westtrade/lesa-lsph-40/elem-peremychka.png

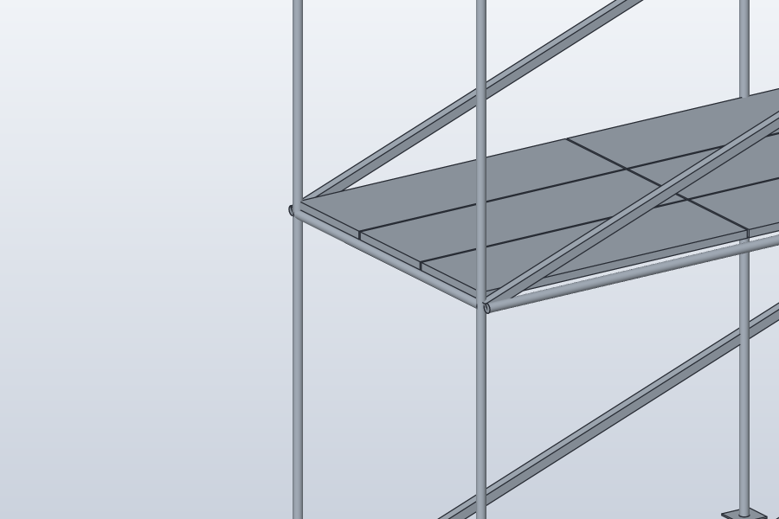
elem-peremychka.png
