westtrade/lesa-lsph-40/lesa-end.png

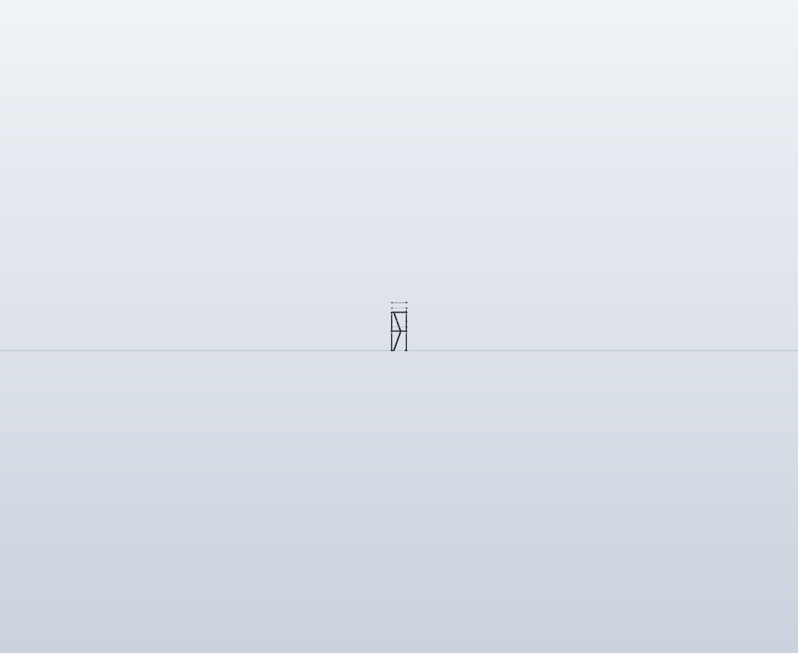
lesa-end.png
