westtrade/lesa-lsph-40/README.md

# Леса строительные ЛСПХ-40 — 60 м × 4 м

Проектный комплект: модель, виды, ведомость и расчёт.

**Дата расчёта:** 21.10.2026 · **источник номенклатуры и цен:** каталог ЛСПХ-40, <https://dzsl.ru/catalog/lspkh-40/>

Заказ: длина 60 м, высота 4 м, система ЛСПХ-40 (хомутовые).
**Условия:** работа в помещении (цех), монтаж крановых рельсов; пол — бетонная плита,
шаг колонн 6 м, рельсы длиной 21 м подаются краном; лестница одна (решение заказчика).

## Содержимое папки

| Файл | Что это |
|---|---|
| `index.html` | **Комплект одной страницей** (единственный HTML): схема, назначение элементов с фото, ведомость, подъём, раскосы, расчёт, виды, допущения. Tailwind вшит, автономный |
| `specifikaciya-LSPH-40.md` | Ведомость в Markdown: схема, спецификация, массы, стоимость, допущения |
| `raschet-LSPH-40.md` | Проверочный расчёт: нагрузки, стойка, перемычка, настил, раскос, анкеры, опрокидывание |
| `lesa-LSPH-40.solidcraft` | Параметрическая 3D-модель SolidCraft (456 тел, мм) |
| `lesa-LSPH-40.step` | Экспорт в STEP для сметчика / подрядчика (456 тел) |
| `lesa-iso.png` | Общий вид, изометрия (все 60 м) |
| `lesa-front.png` | Фасад 60 м, общий вид |
| `lesa-elev10m.png` | Фасад, приближённый вид (~14 м): ярусы, связи, перемычки |
| `lesa-end.png` | Торец (поперечная рама 1,5 × 4,0 м) |
| `lesa-plan.png` | План, приближённый вид (~13 м) |
| `lesa-top.png` | Вид сверху всей конструкции |
| `lesa-detail.png` | Изометрия, приближённый вид на начало лесов |
| `lesa-lestnica.png` | Узел подъёма: 2 марша лестницы и люк в настиле |
| `photo-lsph40.jpg`, `photo-lspkh60.jpg` | Фотографии лесов ЛСПХ с сайта производителя (dzsl.ru) |
| `elem-*.png` | Снимки отдельных элементов с модели: стойка, перемычка, связь 5,3, опора, настил, лестница |

`lesa-elev10m`, `lesa-plan`, `lesa-detail`, `lesa-lestnica` — это те же леса целиком,
только камера подведена (скрытых элементов нет): продольные связи и настил уходят за
правый край кадра и продолжаются, как в натуре. Общие виды — `lesa-iso`, `lesa-front`,
`lesa-top`. Все виды сняты с текущей модели (456 тел: настил на двух ярусах, люки, лестницы).

## Кратко

Схема: 60 м = 24 пролёта по 2,5 м; 25 осей × 2 ряда = 50 стоек; ширина яруса 1,5 м;
высота 4,0 м = 2 яруса по 2,0 м. Раскос — на два пролёта (5,0 м); диагональ панели
5,0 × 2,0 м равна 5,385 м, поэтому каталожная деталь 5,3 м ставится с креплением ниже
узла (подъём 1,758 м).

| Поз. | Наименование | Кол-во |
|---|---|---:|
| 1 | Стойка 4 м | 50 |
| 2 | Перемычка (1,452 м) | 50 |
| 3 | Связь 5,3 м (48 пояса + 20 раскосов) | 68 |
| 4 | Опора простая (башмак) | 50 |
| 5 | Кронштейн прямой (по колоннам через 6 м) | 8 |
| 6 | Кронштейн поворотный | 3 |
| 7 | Настил деревянный 0,5×1,5 | 240 |
| 8 | Лестница наклонная (одна, 2 марша) | 2 |
| 9 | Хомут поворотный / неповоротный | 304 (292 по расчёту + 4 %) |
| 10 | Анкер крепления к колонне M10 (2 на кронштейн) | 22 |

Итоги разделены: **позиции 1–8** — 468 шт., ≈ 6 144 кг, 317 124 ₽ (эта сумма и есть
оценённая стоимость); **весь комплект 1–10** — 797 шт., ≈ 6 256 кг; **с ограждениями (11–12)** — ≈ 7 462 кг, позиции 8–9 — по запросу.

**Как забираться**: настил на обоих ярусах + 3 наклонные лестницы по 2 марша
(земля → +2,0 м → +4,0 м), выход через люк 0,6 × 0,7 м в настиле. Марш: подъём 2 024 мм,
тетива 2 154 мм, уклон 70°, проекция 737 мм, 6 ступеней с шагом 289 мм (≤ 300 мм).
Узел подъёма — `lesa-lestnica.png`.

**Почему раскосы так**: узел на хомутах шарнирный, неизменяемость даёт треугольник.
Раскос идёт на два пролёта (5,0 м). Диагональ панели 5,0 × 2,0 м равна 5,385 м, то есть
каталожная деталь 5,3 м на 85 мм короче и «узел-в-узел» не встаёт — конец крепится
хомутом к стойке ниже узла (подъём 1,758 м, 19,4°); в модели раскос ровно 5 300 мм.
Блоки — 5 шт. (пролёты 1–2, 6–7, 12–13, 18–19, 22–23), наибольший участок без раскоса
10 м. Достаточность шага связей проверяется расчётом/ППР; консервативный вариант —
12 блоков: 96 связей, 362 хомута, 22 анкера, ≈ 6 847 кг (≈ 6,8 т округлённо), 364 276 ₽ — оценка позиций 1–8.

Подробности и допущения — в `specifikaciya-LSPH-40.md`.
