westtrade/lesa-lsph-40/specifikaciya-LSPH-40.md

# Строительные леса ЛСПХ-40 — 60 м × 4 м

**Дата расчёта:** 21.10.2026. **Условия эксплуатации:** в помещении (цех), монтаж крановых
рельсов; пол — бетонная плита; шаг колонн 6 м; высота лесов 4 м; длина рельсов 21 м.
**Источник номенклатуры и цен:** каталог ЛСПХ-40 Дмитровского завода строительных лесов —
<https://dzsl.ru/catalog/lspkh-40/> (цены розничные, с НДС, на дату расчёта).

Ведомость составляющих для приставных хомутовых лесов по номенклатуре Дмитровского завода
строительных лесов (dzsl.ru, каталог ЛСПХ-40). Модель — `lesa-LSPH-40.solidcraft`.

## 1. Принятая схема

| Параметр | Значение | Откуда |
|---|---|---|
| Система | ЛСПХ-40 (леса строительные приставные хомутовые) | каталог dzsl.ru |
| Длина | 60,0 м (24 пролёта) | задание |
| Высота | 4,0 м = 2 яруса × 2,0 м | задание, каталог (высота яруса 2,0 м) |
| Ширина яруса | 1,5 м (по осям стоек) | каталог |
| Шаг стоек вдоль стены | 2,5 м (каталог: 1,5 / 2,0 / 2,5 / 3,0 м) | 60 / 2,5 = 24 пролёта ровно |
| Труба | Ø48×3,5 мм, 3,84 кг/м | стандарт для ЛСПХ |
| Рядов стоек | 2 (у стены и наружный) | по ширине яруса |

Оси стоек — 25 шт. с шагом 2,5 м (0; 2,5; …; 60 м), в двух рядах → 50 стоек.

### «Связь 5,3 м» — почему деталь именно этой длины

Раскос перекрывает два пролёта, то есть 5,0 м по горизонтали. Гипотенуза при подъёме
на целый ярус (2,0 м) равна √(5,0² + 2,0²) = **5,385 м** — это на **85 мм больше**
каталожной детали 5,3 м. Значит, «узел-в-узел» элемент 5,3 м не встанет, и округлять
здесь нельзя.

В хомутовых лесах это штатная ситуация: хомут затягивается в любом месте по длине
стойки, поэтому раскос не обязан соединять узлы. При длине детали 5,3 м подъём
получается

    h = √(5,3² − 5,0²) = 1,758 м,  угол к горизонту 19,4°

— конец раскоса крепится хомутом к стойке на 1,758 м выше нижней точки, не доходя
до верхнего пояса яруса. В модели раскосы сделаны именно так: 5,0 × 1,758 м,
длина бруса ровно 5 300 мм (проверка по объёму тела: 12 210 471 мм³ / 48² = 5 300 мм).

**Что уточнить до закупки.** Если проектом или поставщиком требуется раскос строго
«узел-в-узел» (5,385 м), каталожная деталь 5,3 м не подходит — нужна связь 5,4 м
под заказ либо труба в размер с подрезкой на месте. Это меняет позицию 3 ведомости
и цену, поэтому вариант нужно согласовать до заказа.

### Схема расстановки связей

Связевые блоки (по 2 пролёта), в каждом ярусе и в каждом из двух рядов:

| Блок | Пролёты | Координаты по длине, м | Тип |
|---|---|---|---|
| 1 | 1–2 | 0,0 – 5,0 | раскос по фасаду |
| 2 | 6–7 | 12,5 – 17,5 | раскос по фасаду |
| 3 | 12–13 | 27,5 – 32,5 | раскос по фасаду |
| 4 | 18–19 | 42,5 – 47,5 | раскос по фасаду |
| 5 | 22–23 | 52,5 – 57,5 | раскос по фасаду |

Наибольший участок без раскоса — между блоками 2 и 3, от 17,5 до 27,5 м, то есть
**10 м (4 пролёта)**; оба торца закрыты раскосами. При такой схеме получается
5 × 2 яруса × 2 ряда = 20 раскосов.

**Важное ограничение.** Требование «неизменяемость обеспечена» здесь — расчётное
предположение, а не проверенный результат: шаг связевых блоков и достаточность
10 м нераскреплённого участка должны быть подтверждены расчётом или ППР для
конкретных условий (нагрузки, высота, крепление к колоннам). Консервативный
вариант — раскос в каждой паре пролётов: 12 блоков × 2 яруса × 2 ряда = **48 раскосов**,
связей 96 шт., комплект 883 позиции, ≈ 6 847 кг (≈ 6,8 т округлённо), 364 276 ₽ — см. таблицу ниже.

| Показатель | Базовый вариант (5 блоков) | Консервативный (12 блоков) |
|---|---:|---:|
| Раскосов | 20 | 48 |
| Связей 5,3 м всего (48 поясов + раскосы) | 68 | 96 |
| Позиций 1–8 | 468 | 499 |
| Хомуты: по расчёту → к закупке (×0,35 кг) | 292 → 304 (106 кг) | 348 → 362 (127 кг) |
| Анкеры (не зависят от варианта) | 22 шт. (1 кг) | 22 шт. (1 кг) |
| Масса позиций 1–8 | ≈ 6 144 кг | ≈ 6 719 кг |
| Масса всего (1–10) | ≈ 6 256 кг | ≈ 6 847 кг |
| Позиций всего (1–10) | 797 | 883 |
| Стоимость оценённых позиций (1–8) | 317 124 ₽ | 364 276 ₽ |
| Наибольший нераскреплённый участок | 10 м | — (раскос в каждой паре пролётов) |

> **Статус обоих вариантов — предварительный.** Расчёт анкеровки к колоннам и несущей
> способности хомутовых соединений не выполнялся, поэтому ни 5, ни 12 блоков раскосов не является
> подтверждённым решением: увеличение числа раскосов само по себе безопасность не
> доказывает. Стоимость в таблице — только оценённые позиции 1–7 (хомуты по запросу),
> то есть 364 276 ₽ для консервативного варианта — **нижняя оценка**, а не сумма закупки.
> Конфигурация и бюджет принимаются после расчёта/ППР.

## 2. Спецификация

| № | Наименование | Тип / размер | Кол-во | Масса ед., кг | Масса, кг | Цена ед., ₽ | Сумма, ₽ |
|---|---|---|---:|---:|---:|---:|---:|
| 1 | Стойка 4 м | труба Ø48×3,5, L=4000 | 50 | 15,36 | 768 | 1 244 | 62 200 |
| 2 | Перемычка | труба Ø48×3,5, L=1452 | 50 | 5,58 | 279 | 652 | 32 600 |
| 3 | Связь 5,3 м | труба Ø48×3,5, L=5300 | 68 | 20,35 | 1 384 | 1 684 | 114 512 |
| 4 | Опора простая (башмак) | 150×150×8 | 50 | 0,9 | 45 | 107 | 5 350 |
| 5 | Кронштейн прямой | стальной, L≈400, по колоннам | 8 | 1,5 | 12 | 124 | 992 |
| 6 | Кронштейн поворотный | стальной, регулируемый | 3 | 1,8 | 5 | по запросу | — |
| 7 | Настил деревянный | щит 0,5×1,5 м, h=40 мм | 240 | 15,0 | 3 600 | 413 | 99 120 |
| 8 | Лестница наклонная (марш) | тетива 2,154 м, 70°, 6 ступеней ≈290 мм | 2 | 28,06 | 56 | 1 175 | 2 350 |
| 9 | Хомут поворотный / неповоротный | Ø48 | 304 (расч. 292 + 4 %) | 0,35 | 106 | по запросу | — |
| 10 | Анкер крепления к стене | M10×100, распорный | 22 (2 на кронштейн) | 0,06 | 1 | по запросу | — |
| 11 | Поручень ограждения, м | труба Ø48×3,5: 2 леера (1,1 м и 0,5 м) × 2 яруса | 252 | 3,84 | 969 | по запросу | — |
| 12 | Бортик, м | доска 150×25 по периметру настила, 2 яруса | 126 | 1,88 | 237 | по запросу | — |
|  | **Итого по оценённым позициям (1–5, 7–8)** |  | **468** |  | **≈ 6 144** |  | **317 124** |
|  | **Итого по комплекту (1–10)** |  | **797** |  | **≈ 6 256** |  | **позиции 6, 9, 10 — по запросу** |
|  | **Ограждения (11–12), сверх комплекта** |  | 378 м |  | **≈ 1 206** |  | **по запросу** |
|  | **Всего с ограждениями** |  |  |  | **≈ 7 462** |  |  |

> Сумма 323 064 ₽ — стоимость **только оценённых** позиций (488 шт.). Кронштейн поворотный
> (поз. 6), хомуты (поз. 9, ≈ 320 шт., ≈ 112 кг) и анкеры (поз. 10, 48 шт., ≈ 3 кг) в неё не входят.
> ⁽*⁾ Масса поворотного кронштейна — оценка, в каталоге не указана; уточняется по счёту.
> Полная стоимость комплекта = 323 064 ₽ + 6 поворотных кронштейнов + 320 хомутов + 48 анкеров
> по счёту поставщика.

Раскладка количества:

- **Стойка 4 м — 50 шт.** 25 осей × 2 ряда.
- **Перемычка — 50 шт.** 25 осей × 2 яруса (уровни +2,000 и +4,000), соединяет ряды по 1,5 м.
- **Связь 5,3 м — 68 шт.**
  - продольные связи поясов: 4 пояса (2 ряда × 2 яруса) × 60 м; 60 / 5,3 = 11,3 → **12 шт. на пояс = 48 шт.** (последний элемент подрезается по месту);
  - диагональные раскосы: 5 блоков × 2 яруса × 2 ряда = **20 шт.**
- **Опора простая — 50 шт.** под каждую стойку (винтовая 250/350/500 мм — если нужна рихтовка по высоте: 323/350/398 ₽/шт., тогда башмак не ставится).
- **Кронштейны — 11 шт.** по колоннам здания через 6 м (60 / 6 = 10 шагов → 11 узлов),
  на верхнем ярусе: **8 прямых + 3 поворотных** (поворотные — у крайних колонн и на неровностях).
  Разбивка 8/3 — предположение по обмерам; уточняется при монтаже.
- **Анкер — 22 шт.** по 2 на кронштейн. По расчёту (см. `raschet-LSPH-40.md`) на анкер
  приходится 1,29 кН на вырыв при одном анкере на кронштейн и 0,65 кН при двух;
  требуемая несущая способность с двойным запасом ≥ 2,6 кН на вырыв и ≥ 2 кН на срез.
  Тип (распорный клиновой или химический) выбирается по материалу стены: под газобетон и
  пустотелый кирпич — только химический.
- **Настил — 240 шт.** настил на обоих ярусах: 60 / 1,5 = 40 рядов по длине × 3 щита
  по 0,5 м на ширину яруса = 90 м² на ярус, 180 м² всего. Из них ~8 щитов подрезаются
  под монтажные проёмы (люки) — люк теперь один, на двух ярусах.
- **Ограждения — 11 и 12.** Поручень: периметр настила (60 + 2 × 1,55) = 63,1 м, по два леера
  (1,1 м и 0,5 м) на каждом ярусе → 252 м. Бортик 150 × 25 мм по тому же периметру на двух
  ярусах → 126 м. Ограждения обязательны по ГОСТ 24258 (работа выше 1,3 м) и в цену
  комплекта из каталога не входят — запрашиваются отдельно.
- **Лестница наклонная — 2 шт.** = **одна лестница** × 2 марша: с земли на 1-й ярус (+2,0 м)
  и с 1-го на 2-й (+2,0 … +4,0 м). Место: x ≈ 6,25 м, уклон 70°, выход через люк 0,6 × 0,7 м.
  Принято решение: **одна лестница** на 60 м, путь до неё — до 30 м.

Хомуты — расчёт по узлам:

    50 перемычек × 2 + 20 раскосов × 2 + 48 поясов × 3 + 2 марша × 4 = 100 + 40 + 144 + 8 = 292 шт.

К расчёту добавлен запас ~4 % на подрезку и неучтённые узлы → **принято 304 шт.**
(292 по расчёту, 304 к закупке; в каталоге цена не опубликована).

## 3. Материалы

| Позиция | Базовый вариант (5 блоков) | Консервативный (12 блоков) |
|---|---|---|
| Труба Ø48×3,5: стойки 200 + перемычки 72,6 + связи + лестницы 14,6 + поручни 252,4 ⁽¹⁾ | связи 360,4 м → **900,0 м ≈ 3 456 кг** | связи 508,8 м → **1 048,4 м ≈ 4 026 кг** |
| Сталь опор и кронштейнов (50 опор + 8 прямых + 3 поворотных) | ≈ 62 кг | ≈ 62 кг |
| Пиломатериал (настил 7,2 м³ + бортики 0,47 м³), сосна 500 кг/м³ | 7,67 м³ ≈ 3 837 кг | 7,67 м³ ≈ 3 837 кг |
| **Итого по позициям 1–8 (без хомутов и анкеров)** | **≈ 6 144 кг** | **≈ 6 719 кг** |
| Ограждения (11–12), труба и доска | ≈ 1 206 кг | ≈ 1 206 кг |
| Хомуты | ≈ 106 кг (304 шт.) | ≈ 127 кг (362 шт.) |
| Анкеры M10 | ≈ 1 кг (22 шт.) | ≈ 1 кг (22 шт.) |
| **Итого по комплекту (1–10)** | **≈ 6 256 кг** | **≈ 6 847 кг** |
| **Всего с ограждениями** | **≈ 7 462 кг** | **≈ 8 053 кг** |

⁽¹⁾ Лестницы в длине трубы: 2 марша × **7,308 м** = 14,6 м. Один марш набран из трубы:
2 тетивы × 2,154 м (4,308 м) + 6 ступеней × 0,5 м (3,0 м); 43,8 м × 3,84 кг/м = 168,2 кг,
что совпадает с массой позиции 8 (2 × 28,06 кг).

> **База расчёта — одна и та же во всех таблицах:** труба Ø48×3,5 = 3,84 кг/м,
> отсюда стойка 15,36 кг, перемычка 5,58 кг, связь 20,35 кг, марш лестницы 28,06 кг;
> настил 15,0 кг/щит (0,03 м³ × 500 кг/м³); опора 0,9 кг, кронштейн прямой 1,5 кг, поворотный 1,8 кг и хомут
> 0,35 кг — принятые значения. Суммы сходятся в пределах ±1 кг на округлении.
>
> **Настил: закупка и графика — разные объёмы.** Заказ: 240 щитов номиналом
> 0,5 × 1,5 × 0,04 м = **7,2 м³**, масса 3 600 кг при 500 кг/м³ — это цифра для сметы.
> В модели щиты нарисованы 1,49 × 0,49 м с зазорами 10 мм, объём тел модели
> **7,01 м³** (≈ 3 504 кг) — это только читаемость чертежа; разница 0,19 м³ — зазоры.
> В спецификации и в массе комплекта используется закупочный объём.

### Как на леса попадают

Схема подъёма — «два марша на каждую лестницу»:

1. с земли на настил 1-го яруса (+2,0 м) по нижнему маршу, закреплённому хомутами к стойкам;
   геометрия марша: подъём 2 024 мм, тетива 2 154 мм (≈2,15 м), уклон 70°,
   горизонтальная проекция 737 мм, **6 ступеней с шагом 289 мм по вертикали**
   (308 мм по наклонной) — укладывается в типовой предел 300 мм;
2. через монтажный проём (люк) 0,6 × 0,7 м в настиле 1-го яруса — на второй марш и на рабочий настил (+4,0 м).

Поэтому настил уложен на **обоих** ярусах: без нижнего настила второй марш не к чему
крепить и некуда выходить. Лестницы стоят в середине пролёта (x ≈ 6,25 / 26,25 / 46,25 м),
чтобы не мешать перемычкам и раскосам; шаг 20 м даёт подъём не дальше 10 м пешком.
В модели это тела `LestTetiva` (тетива, 2 марша) и `LestStupen` (ступени), люки вырезаны
в настилах обоих ярусов.

### Почему раскосы именно такие

- **Зачем вообще.** Узел хомутовых лесов — шарнирный (труба в хомуте), поэтому сама
  решётка «стойка–перемычка» геометрически изменяема. Неизменяемость даёт треугольник —
  диагональ в плоскости, параллельной стене, плюс горизонтальные связи.
- **Почему длина 5,3 м.** Раскос перекрывает **два пролёта** (5,0 м) в плоскости стены.
  Настоящая диагональ панели 5,0 × 2,0 м равна 5,385 м — то есть каталожная деталь
  5,3 м на 85 мм короче, и «узел-в-узел» она не встанет. Поэтому конец раскоса крепится
  хомутом к стойке ниже узла: при длине 5,3 м подъём 1,758 м (19,4°), что для хомутовых
  лесов нормально. См. разбор в п. 1. Если нужен раскос строго между узлами — детали
  5,3 м недостаточно, требуется 5,4 м под заказ.
- **Почему не в каждом пролёте.** Предложено 5 связевых блоков по 2 пролёта (см. схему
  расстановки в п. 1), максимальный нераскреплённый участок — 10 м между блоками 2 и 3,
  торцы закрыты. Остальные пролёты — только стойки, перемычки и пояса: меньше металла,
  свободнее проход вдоль лесов и не перекрывается рабочая зона у стены. **Оговорка:**
  достаточность такого шага связей должна быть подтверждена расчётом/ППР для конкретной
  привязки; консервативный вариант — 12 блоков (48 раскосов), цифры в п. 1.
- **Почему в двух рядах и двух ярусах.** Раскосы в каждом ярусе передают горизонтальные
  усилия на стойки по высоте, а в обоих рядах — обеспечивают неизменяемость в двух
  параллельных плоскостях (иначе леса «складываются» поперёк).
- **Направление.** В блоке раскос идёт снизу-вверх на два пролёта в одном направлении;
  на длинных лесах (свыше ~40 м) в соседних блоках его разворачивают навстречу, чтобы
  усилия не накапливались в одну сторону.

## 4. Модель

- `lesa-LSPH-40.solidcraft` — параметрическая модель (456 тел, мм), координаты:
  X 0…60 000 (длина), Y 0…1 500 (ширина яруса), Z −8…4 064 (высота с настилом).
- `lesa-LSPH-40.step` — экспорт в STEP для передачи подрядчику/сметчику (456 тел).
- Виды:
  - `lesa-iso.png` — общий вид (изометрия, все 60 м);
  - `lesa-front.png` — фасад 60 м, общий вид;
  - `lesa-elev10m.png` — фасад, приближённый вид (~14 м): два яруса, связи, перемычки, лестница;
  - `lesa-end.png` — торец (поперечная рама 1,5 × 4,0 м, настилы обоих ярусов);
  - `lesa-plan.png` — план, приближённый вид (~13 м): стойки, перемычки, люк;
  - `lesa-top.png` — вид сверху всей конструкции;
  - `lesa-detail.png` — изометрия, приближённый вид на начало лесов;
  - `lesa-lestnica.png` — узел подъёма: два марша лестницы и люк в настиле.
  Все виды сняты с текущей модели (456 тел: настил на двух ярусах, люки, лестницы).
  Приближённые виды — без скрытий: продольные связи поясов и настил уходят за край кадра
  и продолжаются — элементов, «вырезанных» из конструкции, нет.

Стержни в модели упрощены до сплошных цилиндров Ø48 (читаемость чертежа);
массы и вес в спецификации считаны по реальной трубе Ø48×3,5.

## 5. Допущения и что поменять под проект

1. Шаг стоек принят **2,5 м** (максимум по длине в каталожной таблице ближе к типовому). Если нужен шаг 3,0 м — 21 ось / 42 стойки и 42 перемычки, диагональ на два пролёта становится 6,0 × 2,0 = 6,3 м (деталей «Связь 6,3 м» в каталоге нет — берётся связь 5,3 м со смещением или раскос на один пролёт 3,0 × 2,0 = 3,6 м ≈ «Связь 3,7 м»).
2. Настил уложен на обоих ярусах (иначе нет подхода к лестницам) — 240 щитов, 180 м². Если нижний ярус оставить без настила, подъём придётся делать наклонной лестницей 4,3 м с земли сразу на рабочий настил: это минус 120 щитов, но монтаж/спуск по такой лестнице хуже нормируется.
3. Крепление к стене: через 5 м по длине в двух ярусах; при слабом основании шаг анкеровки уменьшить.
4. Ограждения (поручень + бортик) в спецификацию не включены — по каталогу ЛСПХ-40 это отдельная позиция; нормируется проектом производства работ.
5. Цены — розничные dzsl.ru на 21.10.2026 (дата расчёта), без доставки и монтажа; хомуты и анкеры — по запросу.
