westtrade/lesa-lsph-40/raschet-LSPH-40.md

# Проверочный расчёт лесов ЛСПХ-40 (60 × 4 м)

**Дата расчёта:** 21.10.2026. **Исходные данные по номенклатуре и ценам:** <https://dzsl.ru/catalog/lspkh-40/>.
**Условия:** работа в помещении (монтаж крановых рельсов); пол — бетонная плита;
шаг колонн 6 м; высота лесов 4 м; рельсы длиной 21 м подаются краном.

**Статус документа.** Это проверочный (оценочный) расчёт по нормативным формулам, выполненный
по модели и ведомости комплекта. Он показывает, какие проверки проходят и с каким запасом, и
какие условия обязательны для эксплуатации. Он **не заменяет** проект производства работ
(ППР), не является заключением эксперта и не подписан аттестованным специалистом: перед
монтажом расчёт привязывается к объекту (грунт основания, тип и состояние стены, тип анкера,
район строительства) и утверждается в ППР.

## 1. Исходные данные

| Параметр | Значение |
|---|---|
| Схема | 60 м = 24 пролёта × 2,5 м; ширина яруса 1,5 м; 2 яруса × 2,0 м |
| Стойки | 25 осей × 2 ряда = 50; труба Ø48×3,5 |
| Материал | сталь С245: R<sub>y</sub> = 245 МПа, E = 2,06·10⁵ МПа; настил — сосна: R<sub>и</sub> = 13 МПа, E = 1·10⁴ МПа |
| Сечение трубы | A = 489,3 мм², I = 121 867 мм⁴, i = 15,78 мм, W = 5 078 мм³ |
| Ветровая нагрузка | **отсутствует** — закрытое помещение (п. 1.4: ветер внутри не учитывается) |
| Нормы | СП 20.13330.2016 (нагрузки), СП 16.13330.2017 (сталь), СП 64.13330.2017 (дерево), ГОСТ 24258 (средства подмащивания) |

Допущение по аэродинамике: c = 1,2; коэффициент заполнения несущего контура φ = 0,05 (каркас
без полотна) и φ = 0,70 (смонтирована фасадная сетка). Расчёт ведётся по худшему случаю — с сеткой.

## 2. Нагрузки

- **Постоянная** (настил): щит 15 кг на 0,75 м² → 0,20 кПа. Собственный вес каркаса 2,6 т
  на 240 м² фасада → 0,11 кПа (в расчёте стоек учтён через весовую нагрузку настила и запас).
- **Полезная** на рабочем настиле: **2,0 кПа (200 кг/м²)** — принято по эксплуатационной
  нагрузке лесов; эта же величина покрывает снеговую нагрузку III района (1,5 кПа).
- **Ветровая**: внутри помещения **не учитывается** (F = 0). Это снимает проверку на
  опрокидывание, которая на улице была определяющей.
- **Особый случай — рельс**: рельс длиной 21 м (КР‑70 ≈ 1,1 т, КР‑80 ≈ 1,3 т) подаётся краном
  и укладывается сразу на подкрановые балки. **На настил лесов он не складируется**: сосредоточенная
  нагрузка от куска 12 м (6,2 кН на щит) даёт σ = 17,2 МПа при допустимых 13 МПа — превышение;
  кусок до 6–8 м (3,1 кН) проходит с σ = 8,6 МПа.

## 3. Проверки

| № | Проверка | Усилие | Несущая способность | Использование | Вывод |
|---|---|---|---:|---:|---|
| 1 | Стойка, сжатие с учётом устойчивости | N = 16,5 кН | 36,0 кН (φ·A·R<sub>y</sub>, φ = 0,30) | **46 %** | проходит |
| 2 | Перемычка, изгиб | M = 725 Н·м | σ = 143 МПа при R<sub>y</sub> = 245 МПа | **58 %** | проходит |
| 3 | Настил, изгиб | M = 284 Н·м | σ = 2,17 МПа при 13 МПа | **17 %** | проходит |
| 4 | Раскос, сжатие | N = 0,51 кН | 8,8 кН (эйлерово) | **6 %** | проходит |
| 5 | Анкер к колонне, вырыв | 0,3 кН (случайная нагрузка, принято) | анкер M10 распорный: ≥ 2 кН | **15 %** | проходит |
| 6 | Давление на пол под башмаком | p = 0,73 МПа | R<sub>b</sub> бетона B20 = 11,5 МПа | **6 %** | проходит |
| 7 | Устойчивость | ветра нет; фиксация — 11 кронштейнов к колоннам | конструктивно | — | обеспечено |
| 8 | Ограждения (ГОСТ 24258) | поручень 1,1 м + промежуточный 0,5 м + бортик 150 мм | нормируется, не расчётом | — | выполняется конструкцией |

Пояснения к числам:

1. **Стойка.** Грузовая площадь 2,5 × 1,5 = 3,75 м²; N = (2,0 + 0,2) · 3,75 = 8,25 кН на ярус,
   при загружении двух ярусов — 16,5 кН. Расчётная длина l<sub>ef</sub> = 2,0 м (ярус раскреплён
   перемычками): λ = 127, λ̄ = 4,37; критическая сила по Эйлеру 61,9 кН. Коэффициент
   продольного изгиба φ = 0,30 (кривая b); при φ = 0,25 использование 55 %, при 0,35 — 39 %,
   то есть даже при разбросе табличного φ запас остаётся.
2. **Перемычка.** Пролёт 1,452 м, грузовая полоса 1,25 м: q = 2,75 Н/мм; прогиб 6,34 мм =
   L/229 (для лесов допускается L/150).
3. **Настил.** Щит 490 × 40 мм, пролёт 1,452 м: прогиб 2,39 мм = L/608.
4. **Раскос.** Сдвиг на панель 2,5 × 2,0 м — 0,48 кН; усилие в раскосе 0,51 кН при
   критической силе 8,8 кН (сжатие раскоса не является определяющим).
5. **Анкеры.** Внутри помещения отрывающих усилий от ветра нет, поэтому анкеры работают как
   фиксаторы: расчётное усилие принято 0,3 кН на анкер (случайные толчки, работа с рельсом,
   наезд инструмента). Принято **2 анкера на кронштейн, 22 шт.** (позиция 10 ведомости) —
   с запасом к любому распорному M10, у которого допустимая нагрузка ≥ 2 кН. Под газобетон
   и пустотелый кирпич — химический анкер; здесь основание — бетонная плита.
6. **Пол.** Нагрузка от стойки 16,5 кН распределяется башмаком 150 × 150 мм: p = 0,73 МПа,
   что в 15 раз ниже прочности бетона B20 на сжатие. Для пола по грунту или старого
   асфальта нужны распределительные подкладки 300 × 300 мм.
7. **Устойчивость.** Ветер отсутствует, опрокидывающий момент не возникает. Леса фиксируются
   11 кронштейнами по колоннам через 6 м; при случайном боковом воздействии усилие на
   кронштейн не превышает 0,5 кН — запас по анкеру более чем четырёхкратный.

## 4. Выводы

1. Несущая способность каркаса обеспечена с запасом: наибольшее использование — 58 %
   (перемычка на изгиб), стойка — 46 %, настил — 17 %.
2. **Анкеровка — конструктивная, а не несущая**: ветра в помещении нет, опрокидывание
   невозможно. Достаточно 11 кронштейнов по колоннам через 6 м и 22 анкера (по 2 на кронштейн).
   Это упрощает и удешевляет крепление по сравнению с уличным вариантом.
3. **Определяющими для цеха становятся не ветер, а пол и рельс.** Пол — бетонная плита,
   запас 15-кратный. Рельс 21 м (1,1–1,3 т) на настил не складируется: подаётся краном и
   сразу укладывается на подкрановые балки; на лесах только люди и инструмент (≤ 200 кг/м²).
4. **Ограждения обязательны**: работа на высоте выше 1,3 м — поручень на 1,1 м, промежуточный
   леер на 0,5 м и бортик 150 мм по периметру настила на обоих ярусах (позиции 11–12 ведомости,
   252 м поручня и 126 м бортика, ≈ 1 206 кг). По ГОСТ 24258 они нормируются, а не рассчитываются.
5. Работа идёт в зоне действия крана: нужно согласование с лицом, ответственным за
   безопасную эксплуатацию ГПМ, отключение и блокировка крана на время работ, запрет
   складирования на путях крана.

## 5. Что этим расчётом не проверено

- местная устойчивость стенки трубы (D/t = 13,7 — в пределах нормы, но с учётом коррозии
  толщину надо подтверждать толщиномером);
- несущая способность **хомутовых соединений** — она принимается по паспорту лесов, а не
  расчётом; это отдельное слабое место системы;
- основание под опорами (просадка, уклон площадки), тип и качество анкера, прочность
  материала стены (кирпич/газобетон/монолит) — определяется на объекте;
- динамика от людей, температурные воздействия, сейсмика, усталость, длительная ползучесть
  деревянного настила, работа при обледенении;
- ограждения (поручень, бортик) в комплект не входят и в расчёте не участвуют.

**Для легитимности документа нужны:** привязка к объекту, подпись аттестованного
инженера-конструктора и включение расчёта в ППР.
