westtrade/lesa-lsph-40/elem-lestnica.png

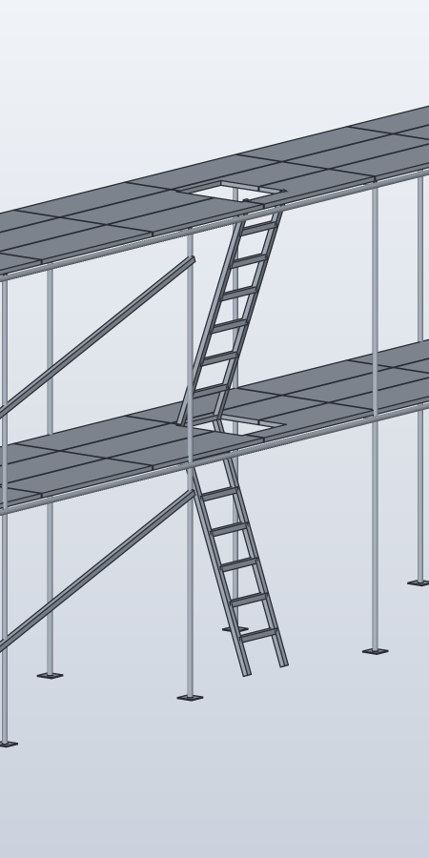
elem-lestnica.png
