westtrade/lesa-lsph-40/elem-nastil.png

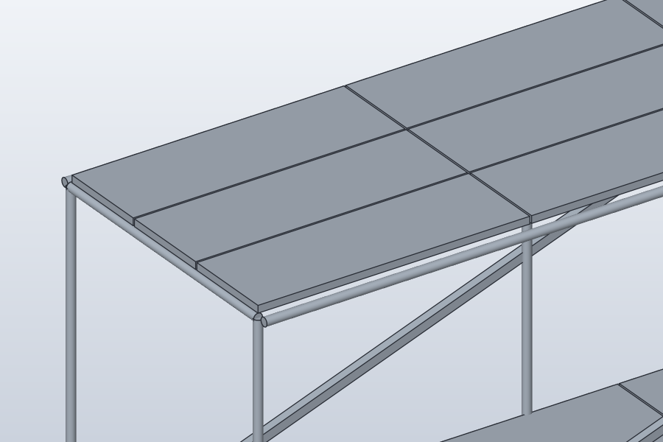
elem-nastil.png
