westtrade/lesa-lsph-40/elem-opora.png

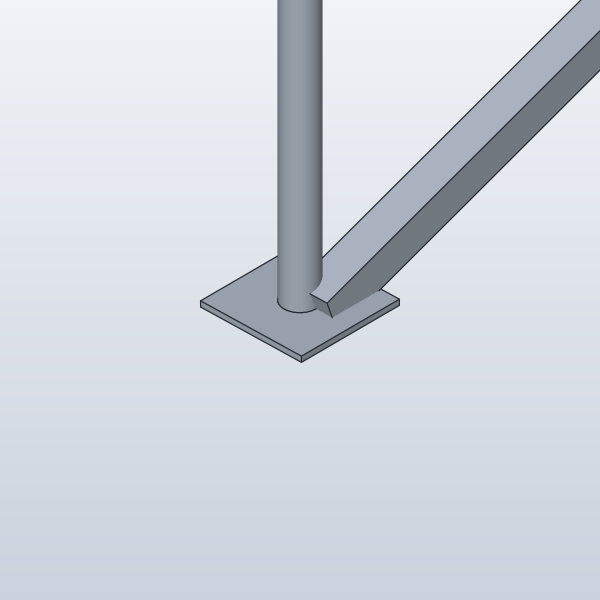
elem-opora.png
