westtrade/lesa-lsph-40/elem-stoyka.png

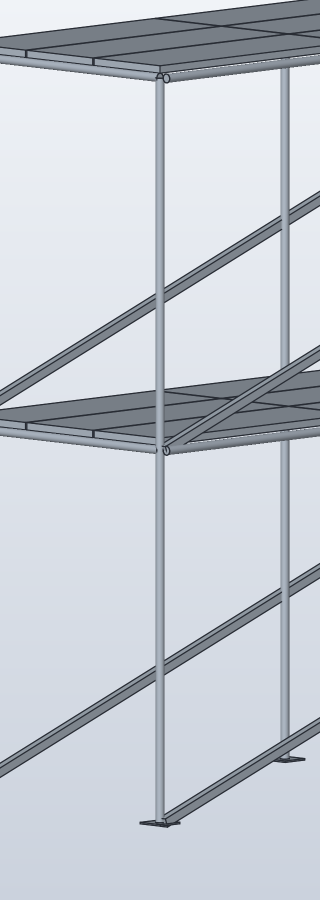
elem-stoyka.png
