westtrade/lesa-lsph-40/elem-svyaz.png

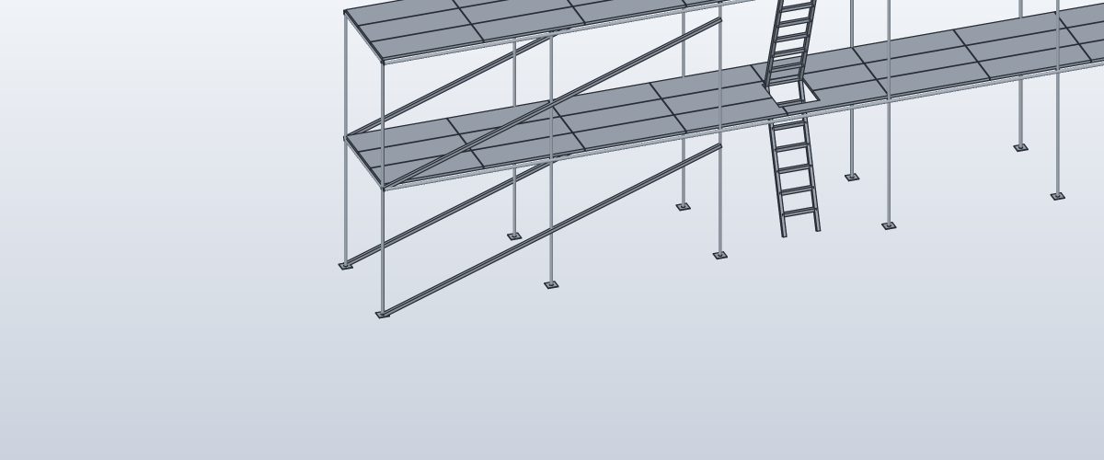
elem-svyaz.png
