westtrade/lesa-lsph-40/lesa-detail.png

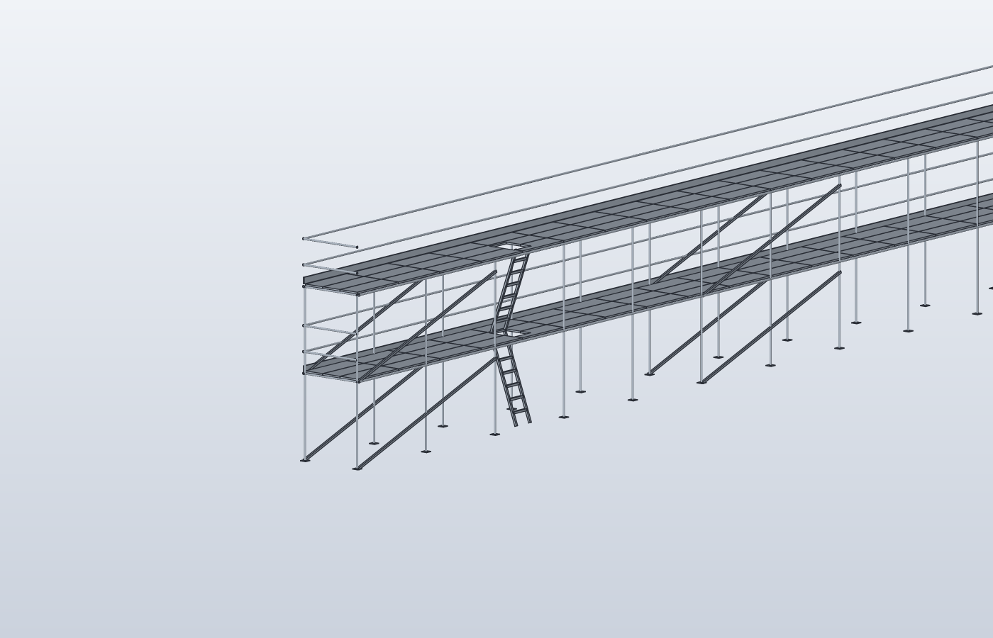
lesa-detail.png
