westtrade/lesa-lsph-40/lesa-elev10m.png

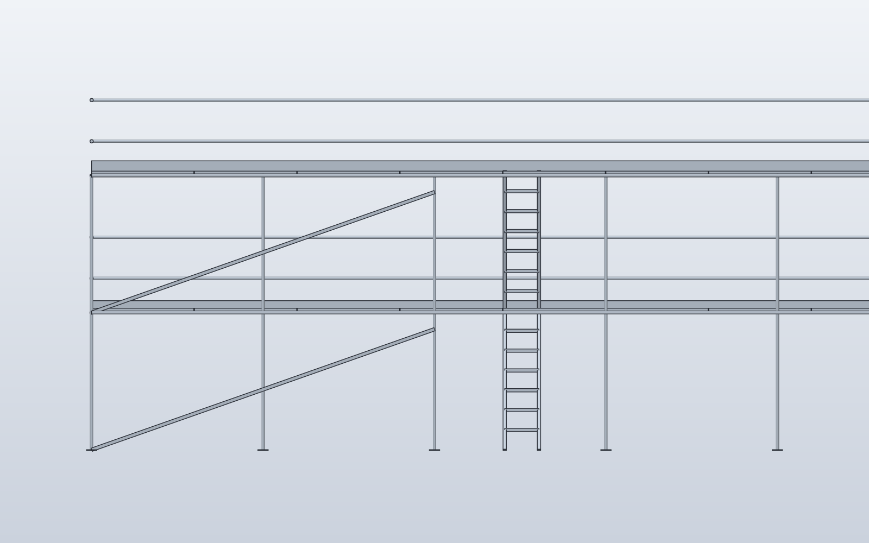
lesa-elev10m.png
