westtrade/lesa-lsph-40/lesa-iso.png

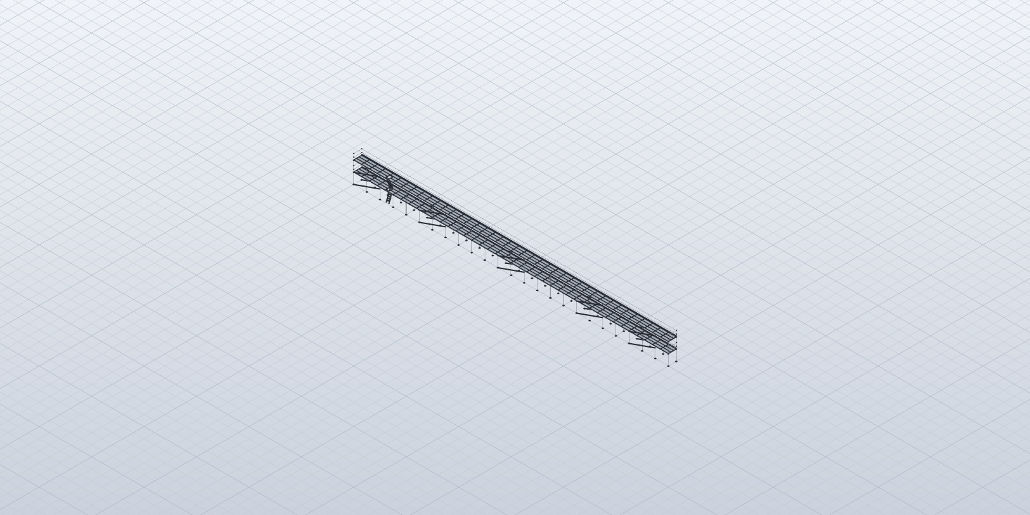
lesa-iso.png
