westtrade/lesa-lsph-40/lesa-lestnica.png

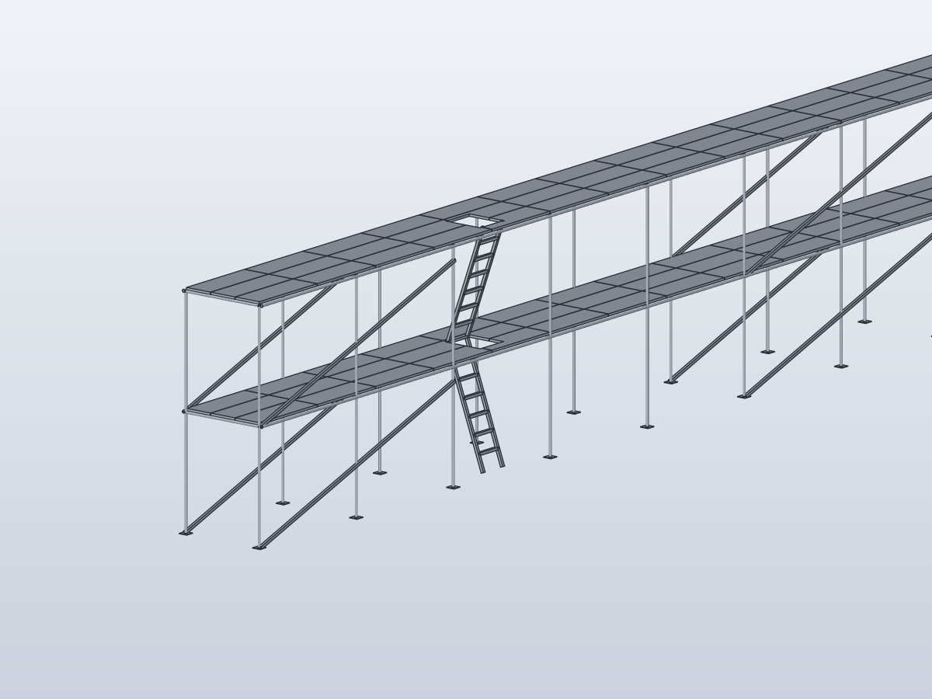
lesa-lestnica.png
