westtrade/lesa-lsph-40/lesa-plan.png

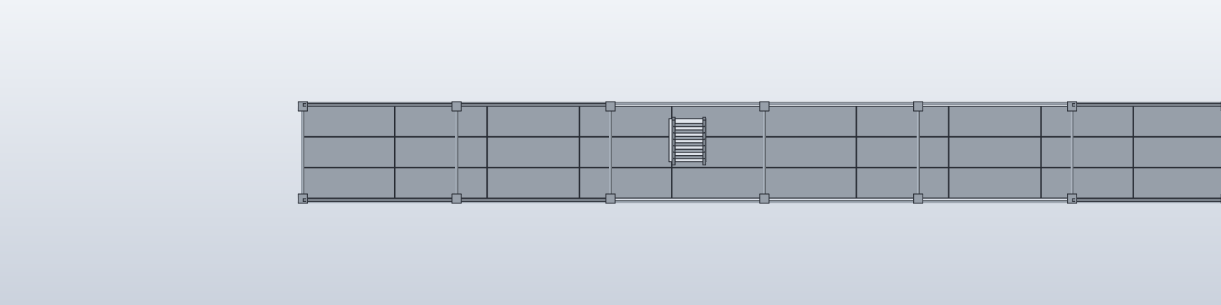
lesa-plan.png
