westtrade/lesa-lsph-40/lesa-top.png

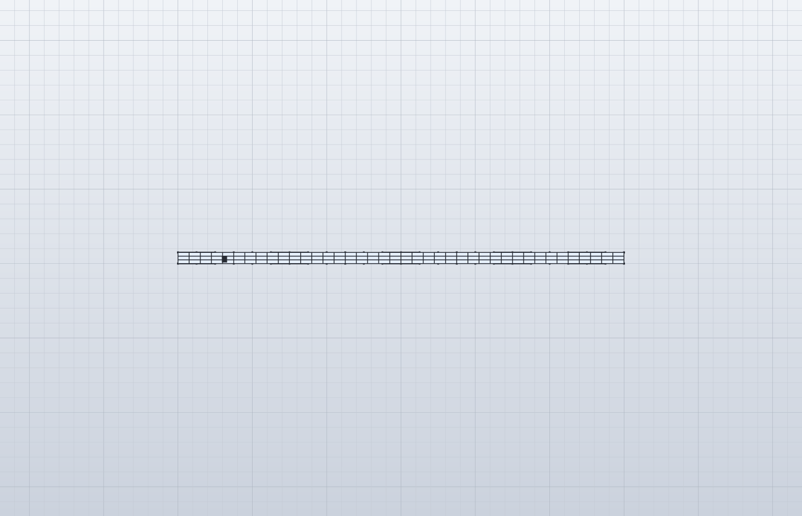
lesa-top.png
