westtrade/lesa-lsph-40/photo-lsph40.jpg

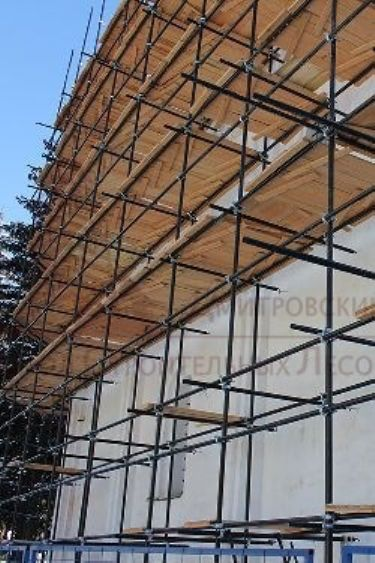
photo-lsph40.jpg
