westtrade/lesa-lsph-40/lesa-LSPH-40.step

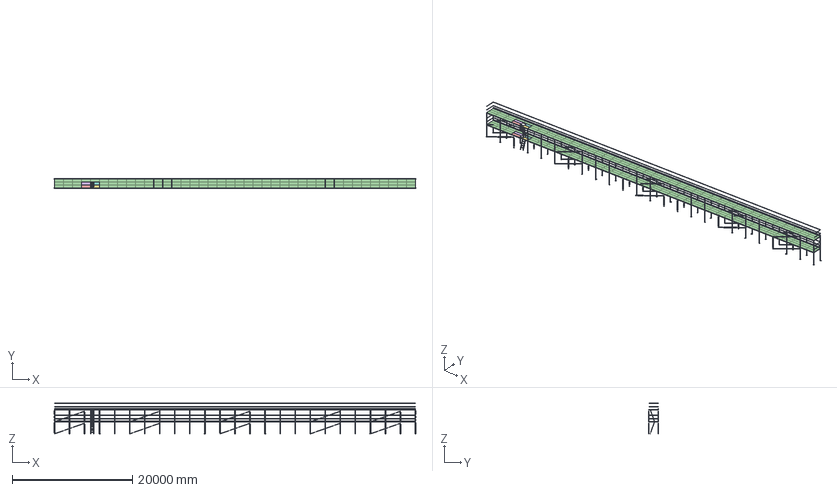
[picture p15: CAD file, 2026-10-21]
lesa-LSPH-40.step
60150.0 x 1650.0 x 5146.6 mm
