westtrade/lesa-lsph-40/(commit log)

2026-10-21 Леса ЛСПХ-40 60×4 м: модель, виды, ведомость, HTML на Tailwind
    Расчёт по каталогу dzsl.ru: 24 пролёта × 2,5 м, 2 яруса по 2,0 м, шаг стоек 2,5 м,
    3 наклонные лестницы по 2 марша с люками в настилах.
    Ведомость: 808 позиций (488 с ценой), ≈ 6 398 кг, 323 808 ₽ за позиции 1–7.
    Модель SolidCraft + STEP AP242 (456 тел), 8 видов PNG, спецификация MD и HTML.
    [lesa-LSPH-40.step]
2026-10-21 Единая база масс, объёмы настила, статус вариантов раскрепления
    - удельные массы пересчитаны по трубе 3,84 кг/м (15,36 / 5,58 / 20,35 / 28,06),
    суммы: 1–7 — 6 280 кг, всего 6 392 кг; консервативный — 6 850 / 6 983 кг;
    - разделены закупочный объём настила (7,2 м³, 3 600 кг) и объём тел модели (7,01 м³);
    - оба варианта раскрепления помечены как предварительные, 370 960 ₽ — нижняя оценка
    без хомутов и без расчёта нагрузок/а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
2026-10-21 HTML: точные удельные массы как в ведомости; расшифровка длины трубы лестниц
    - строки 1-3, 7 приведены к ведомости: 15,36 / 5,58 / 20,35 / 28,06 кг, поперечина L=1452;
    - хомуты: 320 (расч. 308 + 4 %) — как в MD;
    - в материалах пояснено, из чего 43,8 м трубы на лестницы: 6 маршей × (2 тетивы × 2,154 м
    + 6 ступеней × 0,5 м) = 6 × 7,308 м, что даёт те же 168,2 кг.
2026-10-21 Один HTML (index.html), проверочный расчёт несущей способности, анкеровки и устойчивости
    - lesa-LSPH-40.html удалён: единственная страница — index.html (открывается по корню Pages);
    дубли больше не разойдутся;
    - новый raschet-LSPH-40.md: нагрузки (2,0 кПа полезная, ветер 0,0966 кПа с сеткой),
    стойка 46 %, поперечина 58 %, настил 17 %, раскос 6 %, анкер 1,29 кН (22-32 %),
    опрокидывание без анкеров k=1,02 < 1,3 — анкеровка обязательна, k=2,02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
2026-10-21 Анкеры внесены в ведомость (поз. 9), итоги пересчитаны
    Расчёт требует анкер с вырывом >= 2,6 кН, а в закупке его не было — только кронштейны.
    Добавлено: анкер M10x100, 48 шт (2 на кронштейн, запас на тип основания), ~3 кг, по запросу.
    Итоги: 856 позиций (было 808), 6 395 кг (было 6 392); консервативный вариант — 944 / 6 986 кг.
    Усилие на анкер: 1,29 кН при одном на кронштейн, 0,65 кН при двух; проверка в расчёте обновле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
2026-10-21 Дата расчёта и источник номенклатуры
    - во всех документах указана дата расчёта 21.10.2026;
    - источник номенклатуры и цен — каталог ЛСПХ-40 Дмитровского завода
    строительных лесов, https://dzsl.ru/catalog/lspkh-40/ (ссылка в шапке и подвале HTML,
    в шапках спецификации, расчёта и README);
    - примечания о ценах переведены с «на дату запроса» на «на 21.10.2026».
2026-10-21 Материалы: явные границы итогов — поз. 1–7 (без хомутов и анкеров) и комплект 1–9
    Подпись «Всего (без хомутов)» была неточной: 6 280 кг не включают и анкеры.
    Теперь в HTML и в спецификации итоги разделены:
    1–7: 6 280 кг (труба 2 599 + сталь 80 + настил 3 600);
    хомуты 112 кг; анкеры 3 кг;
    комплект 1–9: 6 395 кг (консервативный вариант — 6 986 кг).
2026-10-21 Номенклатура по списку: перемычки, кронштейны прямые и поворотные
    Поперечина -> Перемычка; кронштейн крепления к стене разделён на прямой (18) и поворотный (6);
    остальные позиции (опоры, настил, лестницы, хомуты, анкеры) сохранены как было согласовано.
    Перенумерация: 1 стойка, 2 перемычка, 3 связь 5,3, 4 опора, 5 кронштейн прямой,
    6 кронштейн поворотный, 7 настил, 8 лестница, 9 хомут, 10 анкер.
    Ито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
2026-10-21 Секция «Назначение элементов» с фотографиями производителя
    Добавлен раздел 2: зачем нужна каждая позиция ведомости (стойка, перемычка, связь 5,3,
    кронштейны прямой и поворотный, опора, настил, лестница, хомут, анкер) и почему она такая.
    Две фотографии лесов ЛСПХ взяты с dzsl.ru (каталог ЛСПХ-40 и ЛСПХ-60), положены в репозиторий
    с подписью и ссылкой на источник. Разделы перенумерованы 1-9.
2026-10-21 Фото к каждому элементу: снимки с модели + схемы для узлов
    - в разделе «Назначение элементов» у каждой карточки слева появилось изображение;
    - 6 деталей, которые есть в 3D-модели (стойка, перемычка, связь 5,3, опора, настил,
    лестница) — снимки с модели elem-*.png;
    - кронштейны прямой и поворотный, хомут и анкер в модели не прорабатывались, для них
    нарисованы схемы (SVG) с подписями;
    - общие фотог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
2026-10-21 Перевод на условия помещения: монтаж крановых рельсов, одна лестница, крепление к колоннам
    Новые исходные: работа в цеху (ветра нет), пол — бетонная плита, шаг колонн 6 м,
    высота лесов 4 м, рельсы 21 м подаются краном.
    Модель: удалена вторая и третья лестницы (осталась одна, x ≈ 6,25 м), восстановлены
    настилы на месте двух лишних люков. 428 тел, STEP перезаписан.
    Ведомость: кронштейны 11 (8 прямы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
    [lesa-LSPH-40.step]
2026-10-21 Убрать резервную копию модели из репозитория
2026-10-21 Одна лестница — окончательное решение (убран совет ставить вторую)
2026-10-21 Перерисованы общие виды под модель с одной лестницей (428 тел)
    iso, front, top, end — обновлены; приближённые виды не изменились, потому что
    удалённые лестницы (x ≈ 26,25 и 46,25 м) в их кадр не попадали.
2026-10-21 Ограждения: поручень и бортик — в модели и в ведомости
    Модель: 2 леера на каждом ярусе по внешнему ряду (1,1 м и 0,5 м над настилом) и на торцах,
    бортик 150×25 по периметру настила обоих ярусов. 442 тела, STEP перезаписан.
    Ведомость: поз. 11 поручень 252 м (969 кг), поз. 12 бортик 126 м (237 кг) — цена по запросу.
    Итоги: комплект 1–10 прежний (797 шт., 6 256 кг), с ограждениями ≈ 7 462 кг.
    Материалы: труба 900 м ≈ 3 456 кг, п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
    [lesa-LSPH-40.step]
2026-10-21 Убрать .bak модели из репозитория
